mabooo18/SteiStat/journal/paper4/main.tex

%% Steistat: an open-source, object-oriented AD5941/RP2040 potentiostat,
%% a signal-chain and calibration correction campaign against Analog Devices'
%% AD5940 evaluation-kit reference firmware, and hardware-validated
%% performance characterization (resistor and Randles dummy-cell CV, CA,
%% SWV, DPV).
%% HardwareX article format (Elsevier elsarticle class).
%% Compile: pdflatex main; bibtex main; pdflatex main x2

\documentclass[preprint,12pt]{elsarticle}

\usepackage{amsmath,amssymb}
\usepackage{graphicx}
\usepackage{float}
\usepackage{booktabs}
\usepackage{array}
\usepackage{multirow}
\usepackage{threeparttable}
\usepackage{url}
\usepackage{siunitx}
\sisetup{detect-weight=true,detect-family=true}
\usepackage[table]{xcolor}
\usepackage{tikz}
\usetikzlibrary{positioning,arrows.meta}

\newcommand{\Rcal}{R_{\mathrm{CAL}}}
\newcommand{\Rtia}{R_{\mathrm{TIA}}}
\newcommand{\Rs}{R_{s}}
\newcommand{\Rct}{R_{\mathrm{ct}}}

\graphicspath{{./figures/}}

\journal{HardwareX}

\begin{document}

\begin{frontmatter}

\title{Steistat: Object-Oriented Firmware and Hardware-Validated Accuracy
for an AD5940-Based Potentiostat}

\author[itb]{Kent Frumentius}
\author[itb]{Krishudson Clement}
\author[itb]{Isa Anshori\corref{cor}}
\ead{isaa@staff.stei.itb.ac.id}
\cortext[cor]{Corresponding author.}

\affiliation[itb]{organization={Biomedical Engineering Study Program, School of
    Electrical Engineering and Informatics, Institut Teknologi Bandung},
  city={Bandung}, country={Indonesia}}

\input{sections/0-abstract}

%%Research highlights
\begin{highlights}
\item Steistat is an open-source, AD5941/RP2040 potentiostat built directly
  from Analog Devices' own evaluation-kit reference firmware.
\item The complete hardware design files, bill of materials, and
  firmware source are openly available, enabling independent
  reproduction and further development of the Steistat platform.
\item Across all four electrochemical methods -- cyclic voltammetry (CV),
  chronoamperometry (CA), square-wave voltammetry (SWV), and differential
  pulse voltammetry (DPV) -- the corrected signal chain produces
  correctly-signed, non-degenerate output on real hardware.
\item Cyclic voltammetry against a traceable Randles dummy cell recovers
  $R=\SI{10605.1\pm0.9}{\ohm}$ against a \SI{10560}{\ohm} nominal value
  ($+0.427\,\%$ error, $R^2\geq0.9999986$), independently reproducing an
  earlier measurement on the same corrected firmware.
\item Measurement latency is bounded and datasheet-matched: each
  conversion settles within $\approx$\SI{13.3}{\milli\second}
  ($\approx$\SI{75}{\hertz} ceiling), with every previously unbounded wait
  loop now timeout-protected; against a plain \SI{10}{\kilo\ohm} resistor,
  the same corrected chain recovers $R=\SI{10005.9}{\ohm}$
  ($+0.06\,\%$ error, $R^2=0.9999988$).
\end{highlights}

\end{frontmatter}

\input{sections/1-specifications}
\input{sections/2-hardware-in-context}
\input{sections/3-hardware-description}
\input{sections/4-design-files-summary}
\input{sections/5-bill-of-materials}
\input{sections/6-build-instructions}
\input{sections/7-operation-instructions}
\input{sections/8-validation}
\input{sections/9-discussion}
\input{sections/10-conclusion}

\section*{Data and code availability}
The pre-fix and post-fix firmware source for \texttt{C\_CA}/\allowbreak
\texttt{C\_SWV}/\allowbreak\texttt{C\_DPV}/\allowbreak
\texttt{C\_DCPotentiostatMethod}, the code-verification notes
against the Analog Devices reference examples, this paper's own raw
dummy-cell serial logs (chronoamperometry, cyclic voltammetry against both
the \SI{10}{\kilo\ohm} resistor and the Randles cell, square-wave and
differential-pulse voltammetry), and all hardware design files (schematic,
PCB, Gerbers, BOM, pick-and-place) are available in the project repository,
\url{https://github.com/mabooo18/SteiStat}.

\section*{CRediT authorship contribution statement}
\textbf{Kent Frumentius}: Conceptualization (hardware), Methodology
(hardware), Software, Investigation, Writing -- original draft.
\textbf{Krishudson Clement}: Conceptualization (hardware), Methodology
(hardware), Writing -- review \& editing.
\textbf{Isa Anshori}: Conceptualization, Supervision, Project
administration, Funding acquisition.

\section*{Declaration of competing interest}
The authors declare no competing financial interests or personal relationships
that could have appeared to influence the work reported in this paper.

\section*{Acknowledgements}
%% [DATA REQUIRED]: funding sources/acknowledgements, if any.

\bibliographystyle{elsarticle-num}
\bibliography{references}

\end{document}
