mabooo18/SteiStat/journal/paper4/sections/4-design-files-summary.tex

\section{Design files summary}
\label{sec:design-files}

Table~\ref{tab:designfiles} lists the design files this paper's hardware
and firmware are built from, all available in the project repository
(\url{https://github.com/mabooo18/SteiStat}).

\begin{table}[H]
\centering
\footnotesize
\setlength{\tabcolsep}{4pt}
\caption{Design files summary.}
\label{tab:designfiles}
\begin{tabular}{@{}p{3.4cm}p{2.2cm}p{7.8cm}@{}}
\toprule
Design file name & File type & Location and description \\
\midrule
\texttt{Hardware/\allowbreak STEI\_Bstat\_v1.2.kicad\_sch} & KiCad schematic &
  Full schematic: AD5941 AFE, XIAO RP2040 carrier, RCAL/RCAL2/RCAL3
  calibration bank, WE/RE/CE header \\
\texttt{Hardware/\allowbreak STEI\_Bstat\_v1.2.kicad\_pcb} & KiCad PCB layout &
  \SI{45.0}{} $\times$ \SI{60.0}{\milli\metre}, 2-layer board \\
\texttt{Hardware/\allowbreak Gerber\_PCB.zip} & Gerber (RS-274X) &
  Fabrication files for any PCB manufacturer \\
\texttt{Hardware/\allowbreak Production/\allowbreak bom-1.csv} & CSV bill of materials & Machine-generated
  from the current \texttt{.kicad\_pcb}; source for Table~\ref{tab:bom} \\
\texttt{Hardware/\allowbreak Production/\allowbreak positions.csv} & CSV pick-and-place & Component
  placement (designator, footprint, X/Y, rotation, side) for SMT assembly \\
\texttt{Hardware/\allowbreak Schematic\_AD5941 corr. circ. diag.\_2025-12-14.pdf} & PDF & Rendered
  schematic for quick reference without KiCad installed \\
\texttt{Software/\allowbreak AD5941\_25/} & Arduino sketch (C++) & Complete firmware source:
  \texttt{AD5941\_25.ino}, \texttt{cv.cpp}/\texttt{rampTest.cpp} (legacy CV
  engine), \texttt{src/electrochemical\_methods/} (\texttt{C\_CA},
  \texttt{C\_SWV}, \texttt{C\_DPV}, \texttt{C\_DCPotentiostatMethod},
  \texttt{C\_ElectrochemicalMethod}, \texttt{C\_EIS}, \texttt{C\_OCP},
  \texttt{C\_CV}), \texttt{src/communication/} (\texttt{C\_Communication}),
  \texttt{src/data\_storage/} (\texttt{C\_DataStorage}) \\
\texttt{python\_ui/} & Python (pyserial) & Host-side test/GUI scripts used
  to drive the ASCII command protocol (Section~\ref{sec:operation}) for
  this paper's own validation data collection (Section~\ref{sec:validation}) \\
\bottomrule
\end{tabular}
\end{table}
