mabooo18/SteiStat/journal/paper4/sections/1-specifications.tex

\section*{Specifications table}
\label{sec:specifications}

\begin{table}[H]
\centering
\footnotesize
\renewcommand{\arraystretch}{1.3}
\begin{tabular}{@{}p{3.2cm}p{10.5cm}@{}}
\toprule
\textbf{Hardware name} & Steistat \\
\textbf{Subject area} & Engineering and materials science; Biomedical engineering; Electrochemistry \\
\textbf{Hardware type} & Electrical engineering and computer science -- measuring instrument (potentiostat) \\
\textbf{Closest commercial analog} & Benchtop potentiostat/impedance analyzer (e.g., PalmSens4) \\
\textbf{Open source license} & CERN-OHL-S v2 \\
\textbf{Cost of hardware} & USD \SI{31.07}{} per unit, components only, at single-unit LCSC pricing (Table~\ref{tab:bom}); excludes PCB fabrication and SMT assembly labor. %% [DATA REQUIRED]: add fabrication/assembly cost once quoted.
 \\
\textbf{Source file repository} & \url{https://github.com/mabooo18/SteiStat} \\
\bottomrule
\end{tabular}
\end{table}
