mabooo18/SteiStat/Hardware/DFM analysis report_JLCDFM_STEI_Bstat_v1.2.pdf

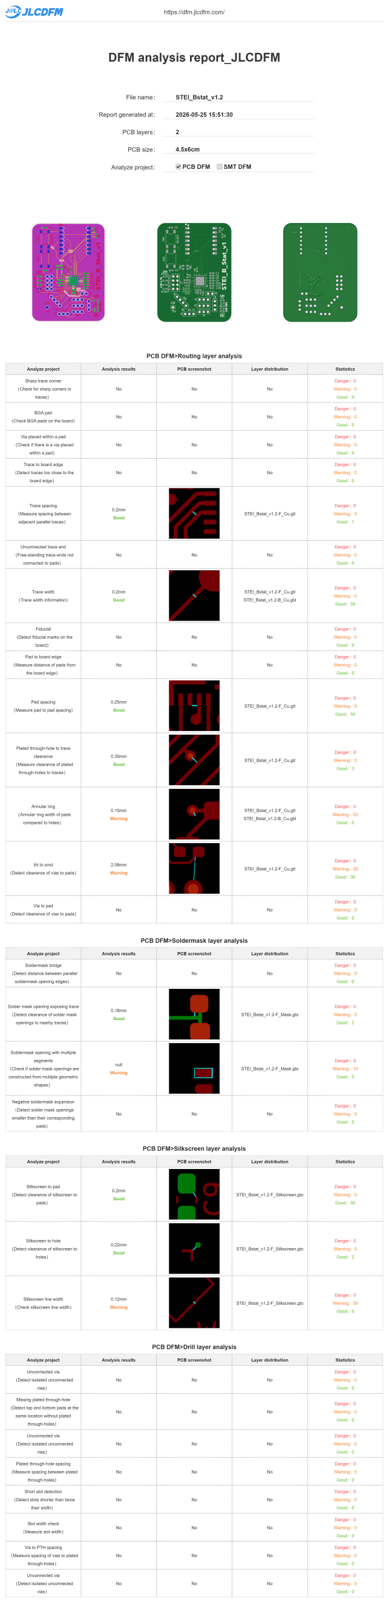
[picture p9: page 1]
