mabooo18/SteiStat/Software/update 8 (22 September 26)/AD5941_25/ppt gambar.pdf

# Update Potensiostat

Dipresentasikan oleh

KENT

### 30 MEI 26

Daftar Isi:
1.Dokumen (diagram blok, RCAL)
2. Foldering Software
3. Laporan jasa Potensiostat

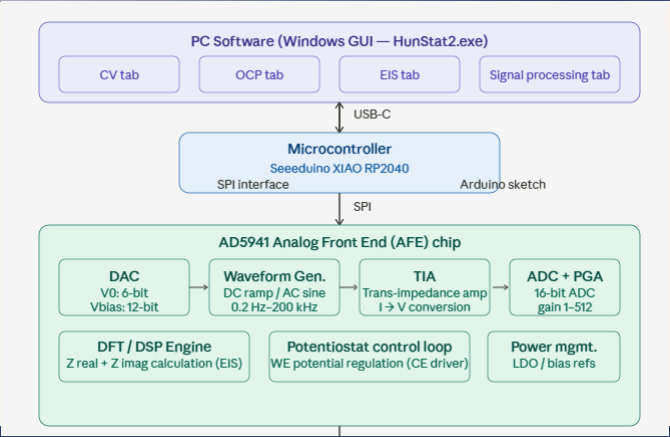
[picture p10: figure]

### 1. Dokumen (Diagram Blok)

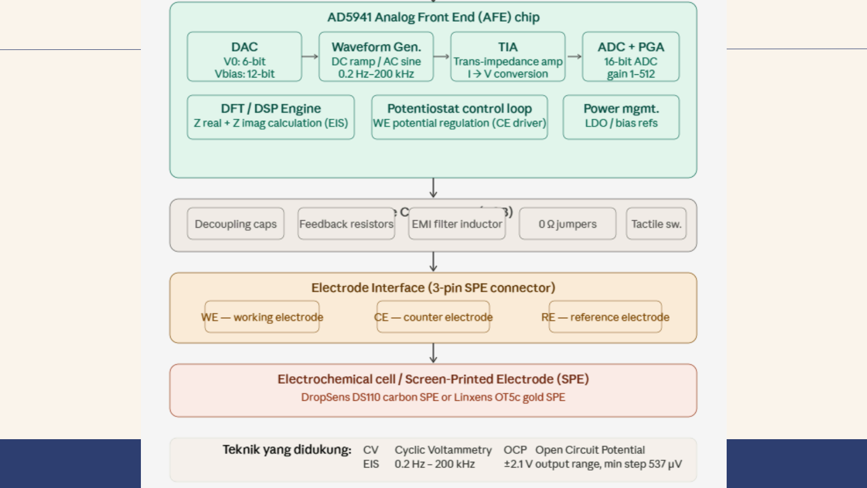
[picture p11: page 4]
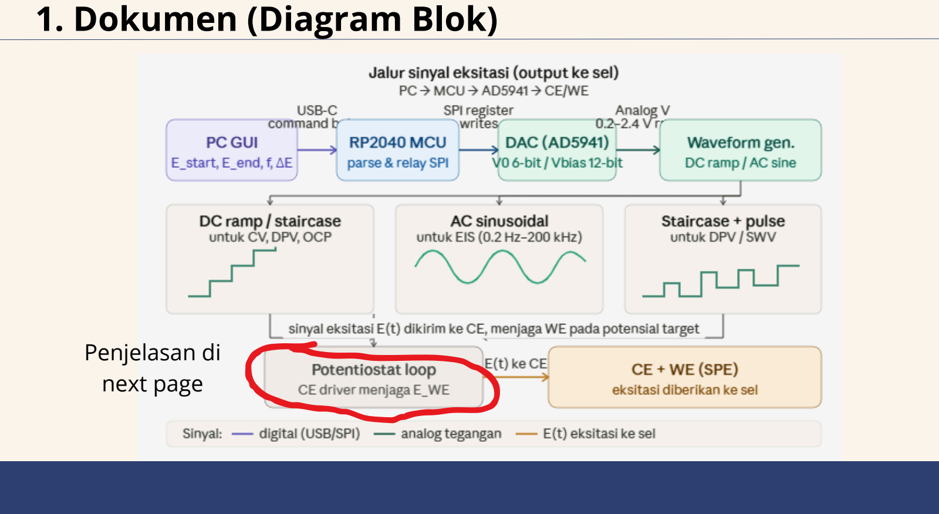
[picture p12: page 5]

### 1. Dokumen (Diagram Blok)

Penjelasan di
next page

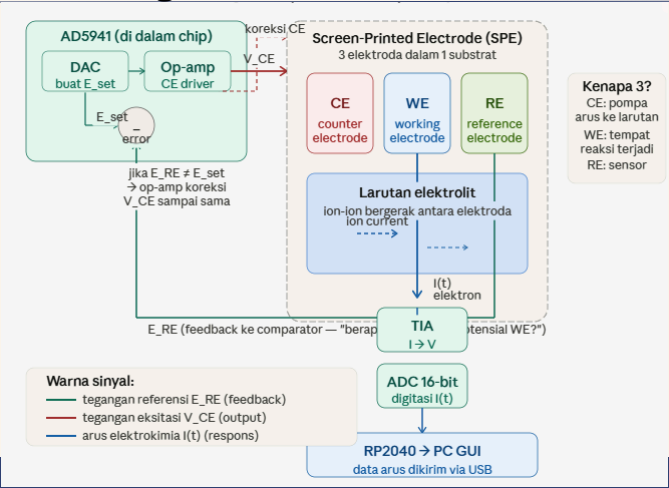
[picture p13: figure]

### 1. Dokumen (Diagram Blok)

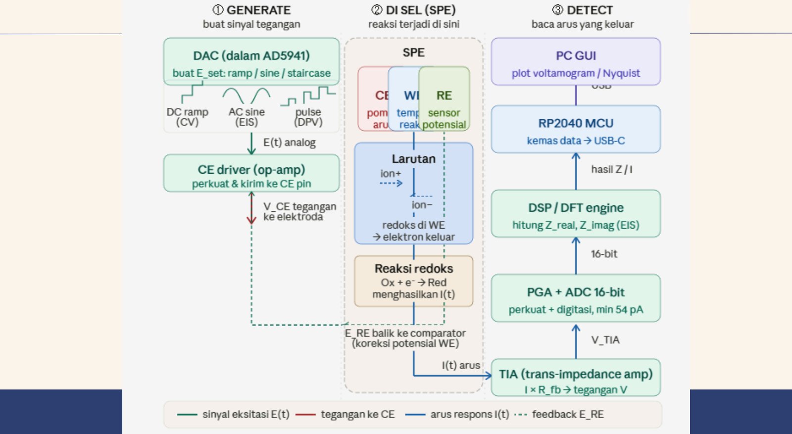
[picture p14: page 7]

### 1. Dokumen (Diagram Blok)

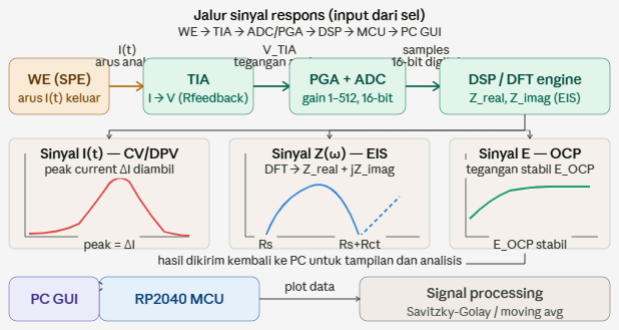
[picture p15: figure]

### 1. Dokumen (RCAL)

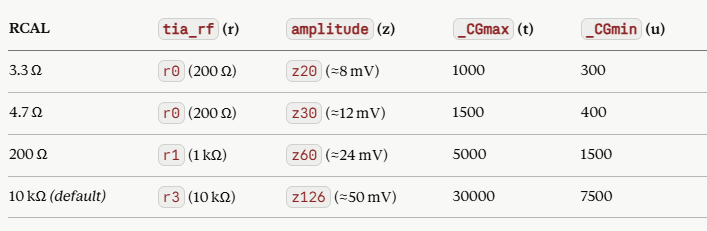
[picture p16: figure]

### 1. Dokumen (RCAL)

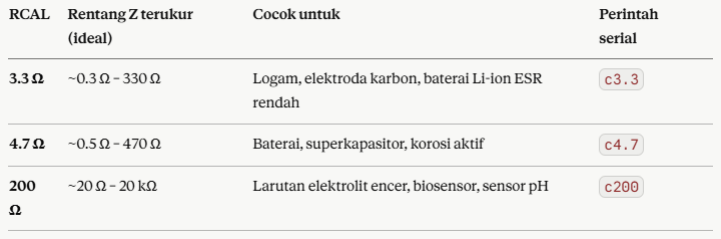
[picture p17: figure]
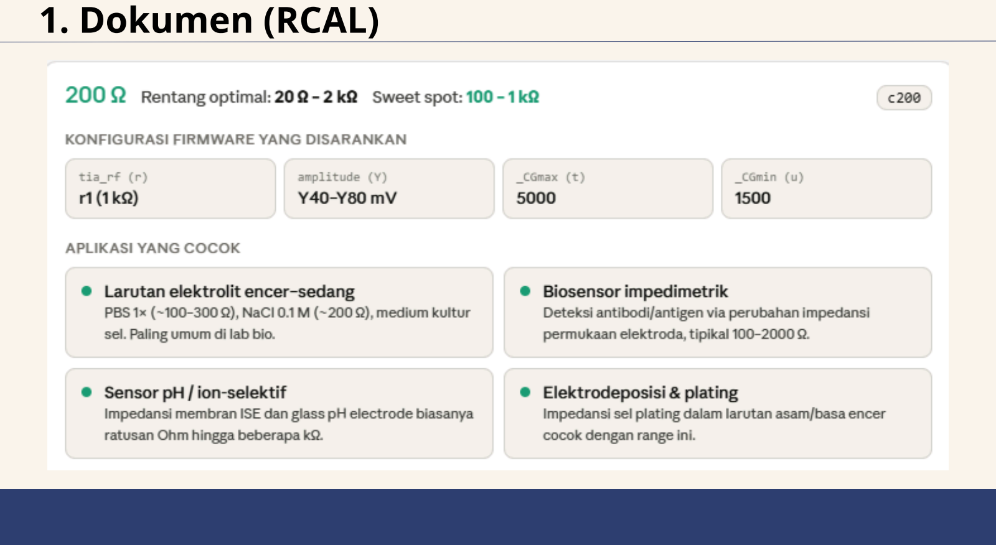
[picture p18: page 11]

### 1. Dokumen (RCAL)

### 1. Dokumen (RCAL)

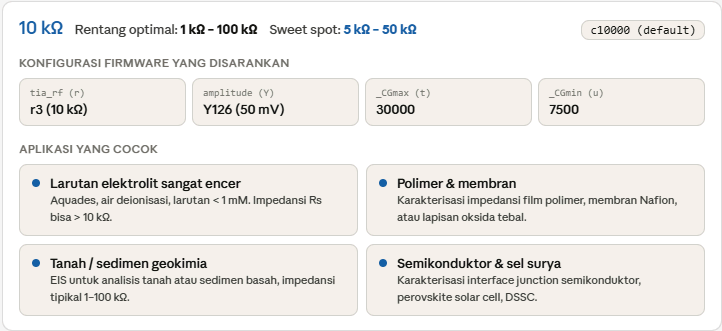
[picture p19: figure]

2.Foldering Software

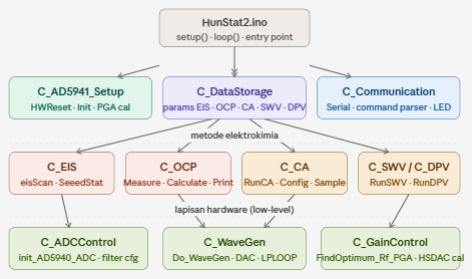
[picture p20: figure]

2.Foldering Software

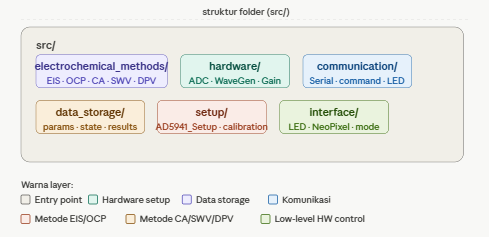
[picture p21: figure]
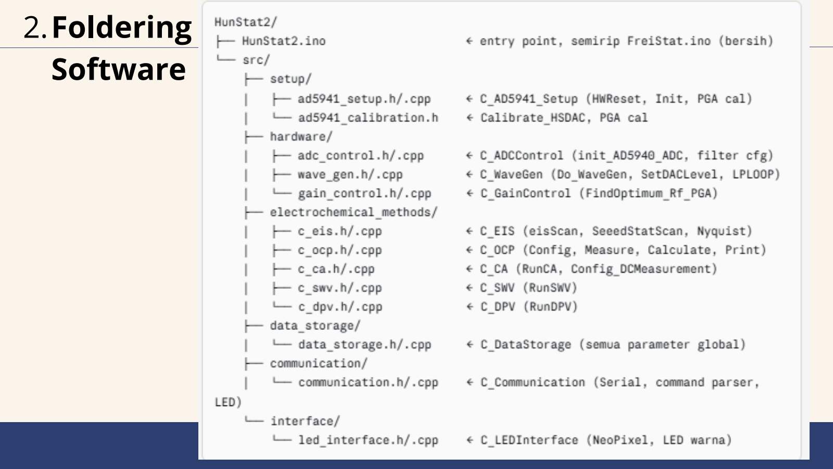
[picture p22: page 15]

2.Foldering
Software

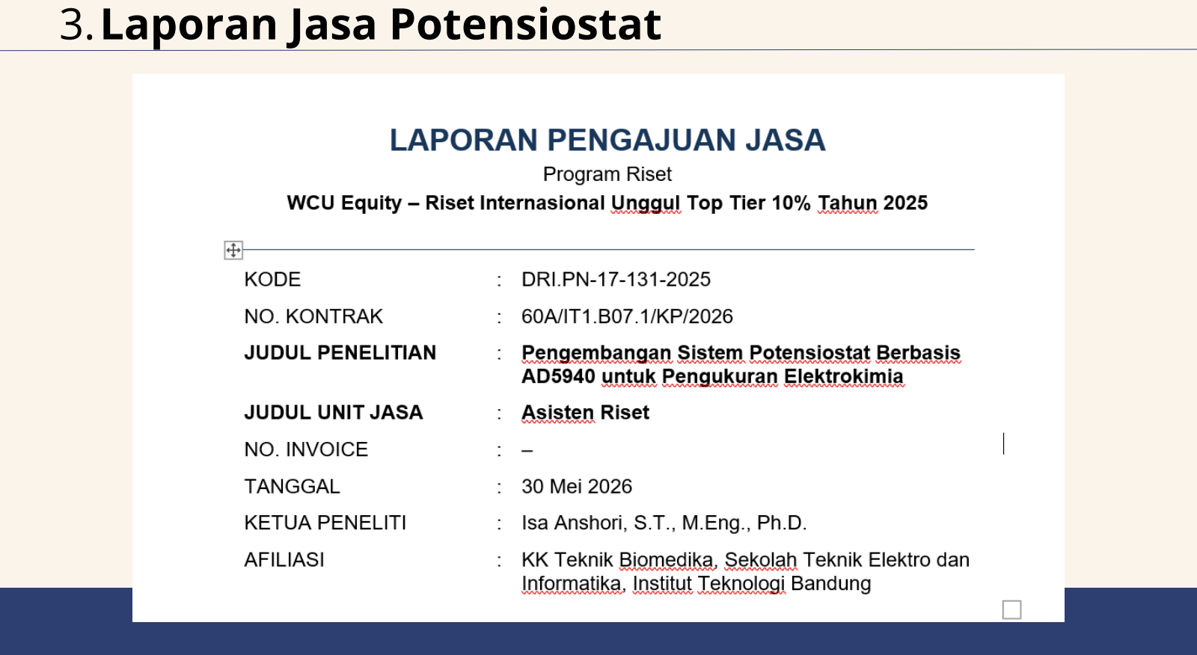
[picture p23: page 16]

3.Laporan Jasa Potensiostat
