mabooo18/SteiStat/journal/paper/figures/fig4_repeatability.pdf

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

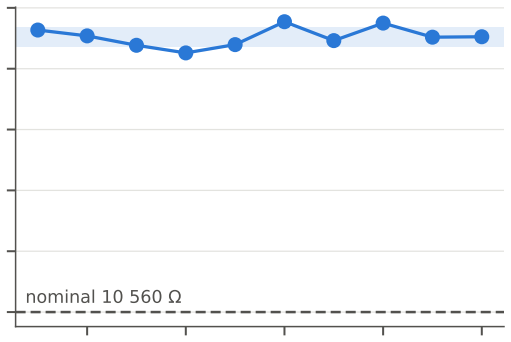
[picture p24: figure]
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
