mabooo18/SteiStat/journal/paper4/figures/fig_cv_linear_fit.png

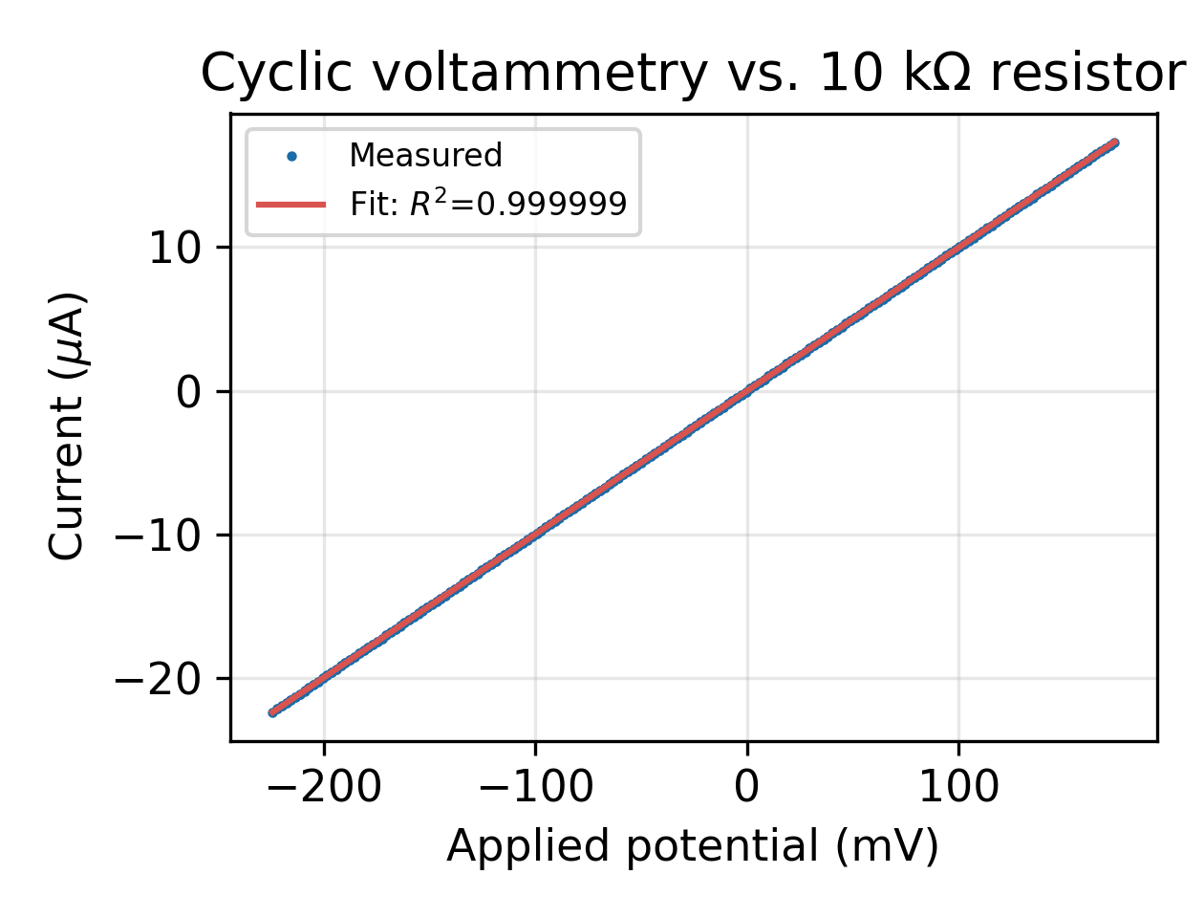
journal/paper4/figures/fig_cv_linear_fit.png
