mabooo18/SteiStat/journal/paper4/figures/fig_dpv.png

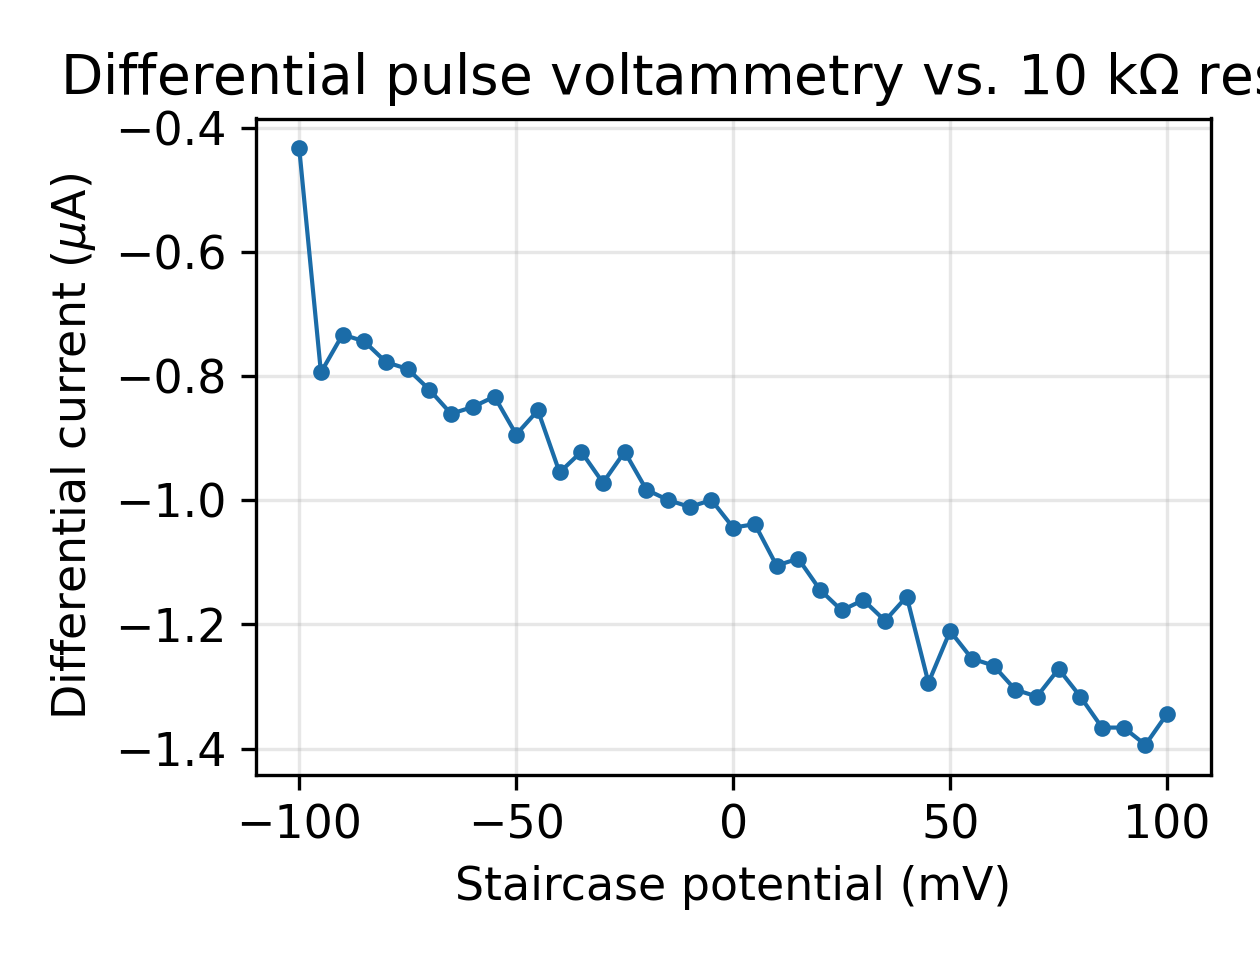
journal/paper4/figures/fig_dpv.png
