mabooo18/SteiStat/journal/paper4/figures/fig_swv.png

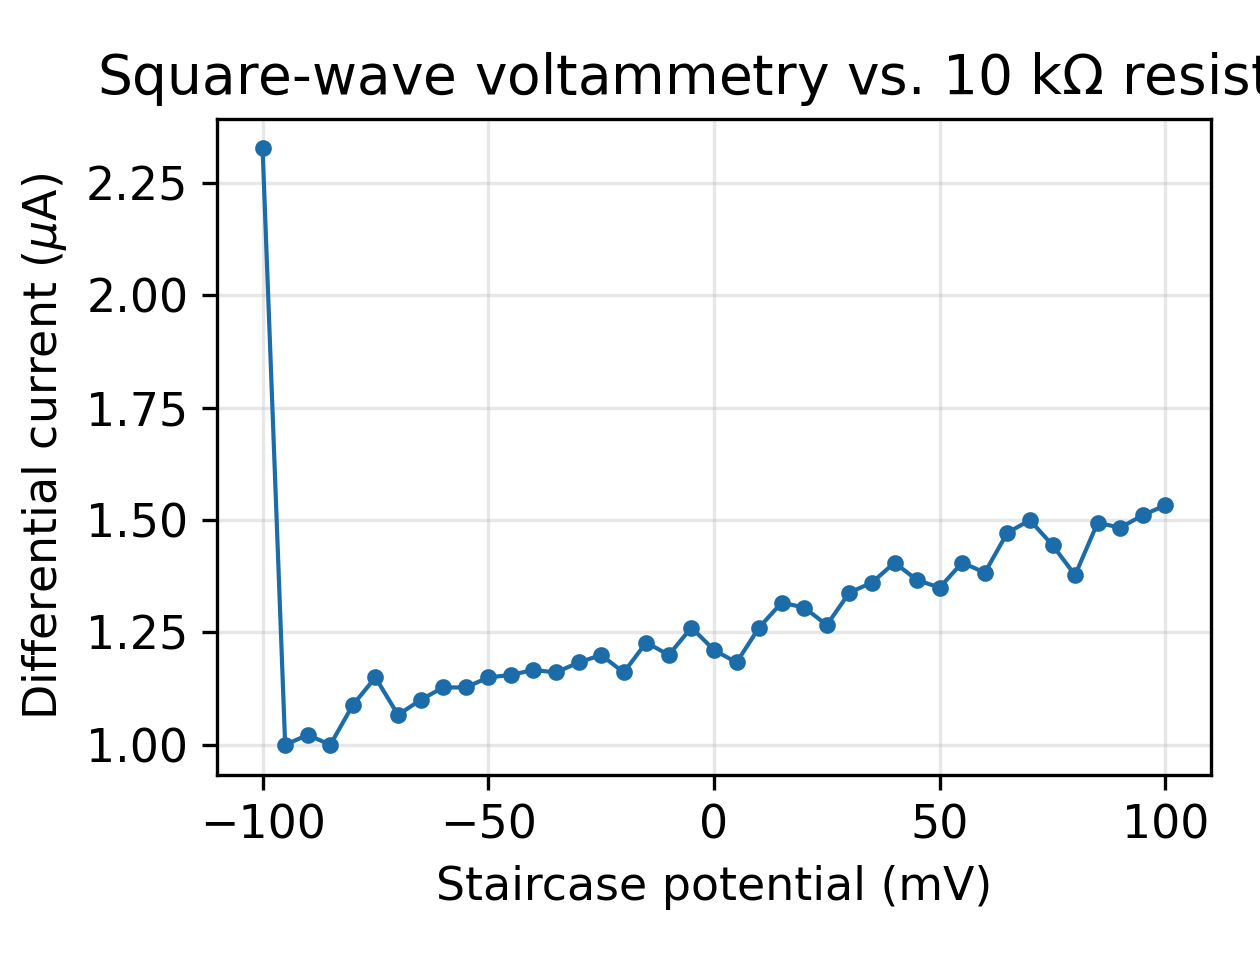
journal/paper4/figures/fig_swv.png
