mabooo18/SteiStat/Software/update 8 (22 September 26)/AD5941_25/hasil/dummy cell.png

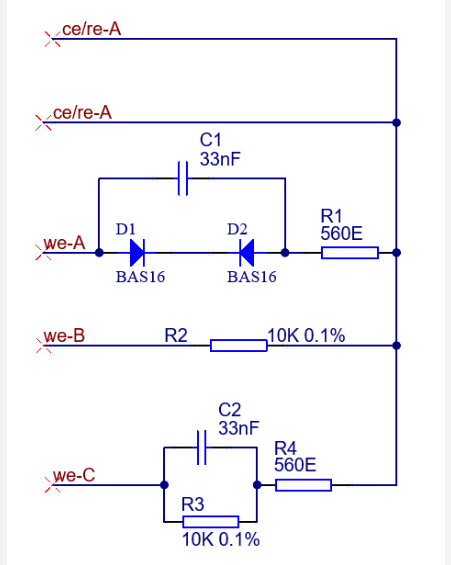
Software/update 8 (22 September 26)/AD5941_25/hasil/dummy cell.png
