mabooo18/SteiStat/Software/update 8 (22 September 26)/AD5941_25/hasil/SWV.png

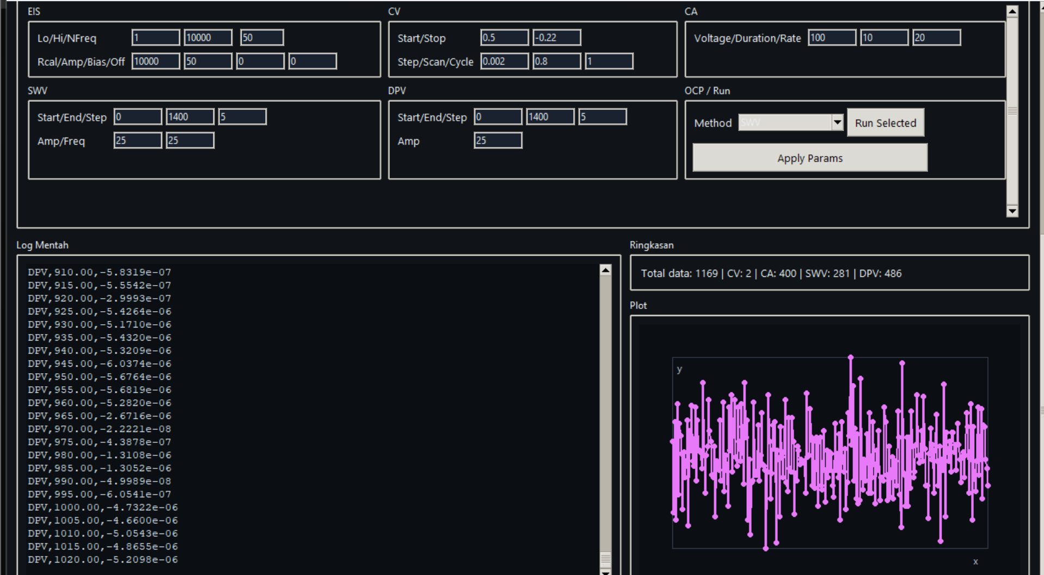
Software/update 8 (22 September 26)/AD5941_25/hasil/SWV.png
