mabooo18/SteiStat/Software/update 8 (22 September 26)/AD5941_25/hasil_fixed/dpv_test1.csv

voltage_mV | delta_current_A
-100.00 | -6.0541e-07
-90.00 | -2.2883e-06
-80.00 | -2.2661e-06
-70.00 | -2.1828e-06
-60.00 | -2.0995e-06
-50.00 | -2.0273e-06
-40.00 | -1.9662e-06
-30.00 | -1.9495e-06
-20.00 | -1.9329e-06
-10.00 | -1.8440e-06
0.00 | -1.8107e-06
10.00 | -1.7274e-06
20.00 | -1.6385e-06
30.00 | -1.6329e-06
40.00 | -1.5441e-06
50.00 | -1.4941e-06
60.00 | -1.4219e-06
70.00 | -1.4385e-06
80.00 | -1.3830e-06
90.00 | -1.3330e-06
100.00 | -1.2552e-06
