mabooo18/SteiStat/Software/update 8 (22 September 26)/AD5941_25/oop_validation/10k_resistor_refactored_only/cv_10k.csv

voltage_mV | current_A
-204.69 | -20.49
-199.85 | -19.98
-195.02 | -19.5
-190.18 | -19.02
-185.35 | -18.55
-180.51 | -18.07
-175.68 | -17.59
-170.84 | -17.08
-166.01 | -16.63
-161.17 | -16.12
-156.34 | -15.64
-151.5 | -15.16
-146.67 | -14.69
-141.83 | -14.21
-137.0 | -13.7
-132.16 | -13.25
-127.33 | -12.74
-122.49 | -12.26
-117.66 | -11.78
-112.82 | -11.31
-107.99 | -10.83
-103.15 | -10.31
-98.32 | -9.84
-93.48 | -9.36
-88.64 | -8.88
-83.81 | -8.4
-78.97 | -7.92
-74.14 | -7.41
-69.3 | -6.93
-64.47 | -6.46
-59.63 | -5.98
-54.8 | -5.5
-49.96 | -5.02
-45.13 | -4.54
-40.29 | -4.06
-35.46 | -3.55
-30.62 | -3.07
-25.79 | -2.6
-20.95 | -2.08
-16.12 | -1.64
-11.28 | -1.13
-6.45 | -0.65
-1.61 | -0.17
3.22 | 0.31
8.06 | 0.79
12.89 | 1.3
17.73 | 1.74
22.56 | 2.25
27.4 | 2.73
32.23 | 3.21
37.07 | 3.72
41.9 | 4.17
46.74 | 4.68
51.58 | 5.16
56.41 | 5.64
61.25 | 6.11
66.08 | 6.59
70.92 | 7.07
75.75 | 7.58
80.59 | 8.06
85.42 | 8.54
90.26 | 9.02
95.09 | 9.5
99.93 | 9.97
104.76 | 10.45
109.6 | 10.93
114.43 | 11.41
119.27 | 11.89
124.1 | 12.4
128.94 | 12.88
133.77 | 13.35
138.61 | 13.83
143.44 | 14.31
148.28 | 14.79
153.11 | 15.27
157.95 | 15.75
162.78 | 16.26
167.62 | 16.7
172.45 | 17.21
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
