mabooo18/SteiStat/Software/update 8 (22 September 26)/AD5941_25/oop_validation/10k_resistor_refactored_only/dpv_10k.csv

x | y
0.0 | -1.0775e-06
20.0 | -1.1386e-06
40.0 | -1.1331e-06
60.0 | -1.2386e-06
80.0 | -1.2664e-06
100.0 | -1.4552e-06
120.0 | -1.4274e-06
140.0 | -1.5441e-06
160.0 | -1.6718e-06
180.0 | -1.7773e-06
200.0 | -1.7773e-06
