mabooo18/SteiStat/journal/02_oop_analysis.md

# OOP Analysis — SteiStat / AD5941_25 Firmware

**Method:** every `.h`/`.cpp` file under `AD5941_25/src/` was read in full. A repo-wide search for `virtual`, `: public` (inheritance), `override`, and `template<` returned **zero matches** in project code (only present, if at all, inside the vendor AD5940 driver — which itself has none either). This single fact governs the whole assessment below: whatever encapsulation exists, there is no inheritance, no polymorphism, and no interface abstraction anywhere in the codebase.

## Per-File Table

| File | Class/Module | Responsibility | OOP Concept Present | Dependencies | Problems | Recommended Improvement |
|---|---|---|---|---|---|---|
| `electrochemical_methods/c_ca.h/.cpp` | `C_CA` | Run one chronoamperometry sweep | Class with private helper methods (`ConfigDCMeasurement`, `MeasureCurrentRaw`, `RawToCurrent`); state is a raw pointer to a shared `C_DataStorage` | Direct calls to ~9 `AD5940_*` register functions, 5 `extern` globals, Arduino `Serial`/`delay` | `ConfigDCMeasurement()` is byte-for-byte duplicated in `C_DPV`/`C_SWV`; class fuses hardware config + unit conversion + timing + LED + Serial I/O; no error handling on ADC timeout | Extract a shared `PotentiostatHAL` for register config; separate a `UnitConverter`; return status/error codes |
| `electrochemical_methods/c_dpv.h/.cpp` | `C_DPV` | Run one DPV sweep | Same shape as `C_CA` | Same as `C_CA` | Verbatim duplicate of `C_CA`'s config/measure/convert code | Same as above; factor common base |
| `electrochemical_methods/c_swv.h/.cpp` | `C_SWV` | Run one SWV sweep | Same shape as `C_CA` | Same as `C_CA` | Verbatim duplicate of `C_CA`'s config/measure/convert code | Same as above |
| `electrochemical_methods/c_eis.h/.cpp` | `C_EIS` | Run EIS frequency sweep + Nyquist conversion | Class, but 2 declared private methods (`CalculateMagAndPhase`, `CalculateNyquistPoint`) are never defined — dead declarations; other helpers live as free `static` functions in the same file, not as methods | ~20 `extern` globals, ~15 `AD5940_*` calls, calls into `measurement_buffer` module | `Run()` is a single ~110-line function mixing clock config, power-mode switching, GPIO, FIFO reads, Serial I/O | Split into `EisFrequencySweeper` + `NyquistCalculator`; move statics into the class or a HAL |
| `electrochemical_methods/c_ocp.h/.cpp` | `C_OCP` | Configure/measure/compute open-circuit potential | Class with one private helper; one more free `static` helper sits outside the class in the same file | ~25 `extern` globals, ~9 `AD5940_*`/Arduino calls | `Calculate()` embeds a magic-number physical formula independently of the near-identical pattern in `RawToCurrent()` (C_CA/DPV/SWV) — same architectural role implemented twice with no shared abstraction | Introduce one shared `AdcCodeConverter` used by all method classes |
| `electrochemical_methods/electrochemical_methods.h/.cpp` | **none — free functions** | Documented ("backward-compatibility") procedural re-implementation of CA/SWV/DPV | None — procedural | Own separate set of global floats duplicating `C_DataStorage` fields | This is a full second implementation of CA/SWV/DPV, with its own copy of the TIA table and `Vref_mV=1820.0` magic number, reading a **different set of globals** than the class versions — a correctness hazard, not just duplication | Delete this file once callers are migrated to the class versions, or delete the classes if this path is the one actually used — do not keep both |
| `communication/communication.h/.cpp` | `C_Communication` | Parse/dispatch serial commands, own a command-history buffer | The **strongest encapsulation in the codebase**: private `m_History[2000]` + `m_pHistory` cursor, only mutated through class methods | Directly calls `AD5940_WriteReg`/`ReadReg`; drives all 5 method classes | Not cohesive — one class is simultaneously a parser (hand-rolled `sscanf` grammar), a 5-way command dispatcher, a hardware-register shim, a logger, and an orchestrator; a switch-case fallthrough pattern (e.g. `case 'B': ...; case 'b': ...`) and a reused `'!'` command code are fragile | Split into `CommandParser` + `CommandDispatcher` + a hardware-access boundary the dispatcher calls through, not around |
| `command_processing/command_processing.h/.cpp` | **none — free functions** | Parallel/legacy command parser | None — procedural | Independent set of ~35 `extern` globals; direct `AD5940_WriteReg`/`ReadReg`/`PGA_Calibration` calls | Near-total duplicate of `C_Communication`'s ~700-line grammar, maintained independently against different globals; `case` labels declare locals without braces (fragile C idiom) | Delete once confirmed unused, or merge into `C_Communication` if still load-bearing |
| `data_storage/data_storage.h/.cpp` | `C_DataStorage` | Central parameter store | **None in practice** — every field is `public`; only method is `Begin()` (sets defaults) | Read/written directly (`m_pData->Field = ...`) by every method class | Textbook "class used only as a namespace/struct"; header comment states its purpose is literally to replace `extern` globals with one shared mutable object — not encapsulation, relocation | Add private fields + accessor methods with validation (e.g. reject out-of-range voltages) if genuine encapsulation is to be claimed |
| `data_storage/measurement_buffer.h/.cpp` | **none — free functions** | Circular/linear measurement buffer | None — procedural, 3 file-scope non-`static` globals | Used by `c_eis.cpp` | A **third, divergent** copy of the buffering concept, alongside `C_DataStorage`'s own `Measurements[]`/`pMeasurement`/`NumberOfMeasurements` fields (note the casing mismatch with this file's `numberOfMeasurements`) | Pick one buffer owner; delete the other |
| `hardware/gain_control.h/.cpp` | **none — free function** `Hardware_FindOptimum_Rf_PGA` | Compute optimal TIA/PGA combination | None — procedural, but genuinely stateless/pure and well-isolated | No globals, no hardware calls | Best-isolated module in the codebase, but not OOP | Could remain a free function; if wrapped in a class it should be a stateless `GainOptimizer` value type, not more than that |
| `hardware/adc_control.h/.cpp` | **none — free function** `Hardware_Init_AD5940_ADC` (aliased `init_AD5940_ADC`) | Configure ADC filter/DFT per frequency band | None — procedural | 4 `extern` globals, 6 `AD5940_*` calls | 6-band if/else chain with unnamed magic-number band edges (`.11`, `.51`, `5`, `450`, `80000`) | Replace band edges with named constants; wrap in a `FilterBankSelector` |
| `hardware/wave_gen.h/.cpp` | **none — free function** `Hardware_Do_WaveGen` (aliased `Do_WaveGen`) | Configure clocks/reference/TIA/switch matrix/waveform generator | None — procedural | 14 `extern` globals, ~8 `AD5940_*` calls | ~90-line function mixing 5+ configuration concerns | Decompose into per-concern setup methods on a HAL class |
| `interface/led_interface.h/.cpp` | **none — free functions** | NeoPixel status LED control | None — procedural | 1 `extern` NeoPixel object it does not own | **Live bug:** `Interface_SetLed(color)` ignores its `color` argument and always renders white — every caller's intended color coding is silently defeated | Fix the bug; wrap the NeoPixel object inside a real `StatusLed` class that owns it |
| `utils/status_utils.h/.cpp` | **none — free functions** | Wraps `interface/led_interface` | None — procedural, pure pass-through | Calls `interface/` functions | Redundant indirection layer — two modules wrapping each other for no added behavior | Delete one of the two layers |
| `setup/ad5941_setup.h/.cpp` | `C_AD5941_Setup` | Chip init + PGA calibration + NeoPixel ownership | Class with one private member (`m_Pixels`) — genuine ownership of a hardware object | Calls `AD5940_HWReset/MCUResourceInit/Initialize/ADCPGACal` | `GetPixels()` returns a raw pointer to the private member, defeating the encapsulation just established; its own wrapped functions (`InitAll`, `PGACalibration`) are bypassed elsewhere in the codebase via direct calls to the underlying free functions, making the class API optional/decorative | Return a reference-with-limited-API instead of a raw pointer; make the underlying free functions private/internal so the class is the only entry point |
| `setup/ad5941_calibration.h` | — | (empty file, 0 bytes) | N/A | N/A | Dead placeholder | Remove or populate |
| `ad5940/ad5940.h/.cpp`, `ad5940/debug.h` | — | Vendor AD5941 register driver | None (confirmed by grep) | N/A — this is the substrate everything else calls into | Not project code; correctly cited as a third-party dependency, not a contribution | N/A |

## Duplication Summary (separate from the per-file table because it crosses files)

The codebase ships **two parallel implementations** of the same functionality in two places:

1. **CA/SWV/DPV**: class-based (`C_CA`, `C_SWV`, `C_DPV`, bound to `C_DataStorage`) *and* free-function (`electrochemical_methods.cpp`, bound to its own separate globals), with identical register-configuration code and magic numbers copy-pasted three times within the class versions alone.
2. **Command processing**: class-based (`C_Communication`, ~622 lines) *and* free-function (`command_processing.cpp`, ~704 lines), each independently implementing the same ASCII command grammar against disjoint sets of global variables.

Both duplications matter for the paper: they are direct evidence against an "OOP refactor" narrative, and they are a correctness risk (two code paths can diverge on the same nominal parameter).

## Overall Verdict: **Partially OOP** (weak end of "partial")

Justification, in order of weight:

1. **No inheritance, polymorphism, or interfaces anywhere in project code.** Five electrochemical-method classes (`C_CA`, `C_DPV`, `C_SWV`, `C_EIS`, `C_OCP`) are a textbook case for a common `IElectrochemicalMethod` base with a virtual `Run()` — none exists. `C_CA::ConfigDCMeasurement()`, `C_DPV::ConfigDCMeasurement()`, and `C_SWV::ConfigDCMeasurement()` are verbatim-identical instead of being one shared base method.
2. **The central "class," `C_DataStorage`, has 100% public fields and a single trivial method.** Its own source comment states its purpose is to replace `extern` globals with one shared object — a relocation of global state, not encapsulation. Every method class reaches directly into its public fields.
3. **Every method class is directly coupled to the vendor register-driver API and to Arduino runtime calls (`Serial`, `digitalWrite`, `delay`) inside the same functions that do unit conversion and protocol framing.** There is no hardware-abstraction-layer interface standing between "measurement logic" and "register access" — which is the opposite of what an "OOP potentiostat" claim would need to demonstrate.
4. **Two full parallel implementations of the command layer and of CA/SWV/DPV exist simultaneously** (class-based vs. free-function), indicating the OOP layer was added alongside, not integrated into, the original procedural firmware.
5. **Genuine encapsulation exists only in two places**: `C_Communication` (private history buffer, real invariant it manages) and `C_AD5941_Setup` (private NeoPixel object, though leaked via a raw-pointer getter). The other six classes use `class` as a grouping syntax indistinguishable from a namespace.

### What this means for the paper

The manuscript **cannot** honestly claim "strong OOP architecture," "polymorphic method dispatch," or "clean hardware abstraction layer" as currently implemented. It *can* honestly claim: a partial migration from procedural/global-variable C toward C++ classes, with identified concrete next steps (Phase 3 architecture) to complete that migration — e.g., a shared base class for electrochemical methods, a real HAL boundary, and removal of the duplicate free-function code paths. Positioning the paper's contribution around "we diagnose the current architecture and propose/implement a completed OOP refactor" is defensible from the evidence; claiming the *current* code is already a mature OOP design is not.
