mabooo18/SteiStat/journal/elsevier.tex

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

\documentclass[preprint,12pt]{elsarticle}

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

\usepackage{amssymb}
\usepackage{amsmath}
\usepackage{graphicx}
\usepackage{array}
\usepackage{url}
\usepackage{float}

\journal{[DATA REQUIRED: Journal Name]}

\begin{document}

\begin{frontmatter}

%% Title, authors and addresses

\title{Design and Implementation of an Object-Oriented Potentiostat\\ With Performance Evaluation Using a Dummy Cell}

%% [DATA REQUIRED]: real author names, affiliations, and contact emails were
%% not available in the repository and must be filled in before submission.
\author[1]{Author~Name}
\author[2]{Author~Name}

\affiliation[1]{organization={[DATA REQUIRED: institution / department]},
            addressline={},
            city={[DATA REQUIRED: city]},
            postcode={},
            state={},
            country={[DATA REQUIRED: country]}}

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

%% \ead{[DATA REQUIRED: corresponding author e-mail]}

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

%%Graphical abstract
\begin{graphicalabstract}
%% [OPTIONAL] \includegraphics{figures/graphical_abstract}
\end{graphicalabstract}

%%Research highlights
\begin{highlights}
\item Audited HunStat2's AD5941/RP2040 firmware and found it configured the wrong excitation/sensing loop for CA/SWV/DPV.
\item Corrected the excitation-loop and ADC zero-point defects and validated the fix on physical hardware.
\item Post-fix CV shows near-ideal linearity against Ohm's law ($R^2 = 0.999997$).
\item Reports an honest, evidence-based audit of the firmware's object-oriented design maturity.
\end{highlights}

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

\end{frontmatter}

%% main text

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

\section{System Design and Implementation}

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

\section{Performance Evaluation}

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

\subsection{Performance Evaluation Against a Dummy Cell}
\label{sec:eval_dummy}

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

\begin{figure}[t]
\centering

\caption{Chronoamperometry current transient following a $0\rightarrow+200$~mV potential step against the dummy cell (\texttt{r3}, 10~k$\Omega$ LPTIA RTIA).}
\label{fig:ca_transient}
\end{figure}

\begin{figure}[t]
\centering

\caption{Initial chronoamperometry transient current versus applied step voltage, showing a polarity- and magnitude-consistent response.}
\label{fig:ca_vs_step}
\end{figure}

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

\begin{figure}[t]
\centering

\caption{Cyclic voltammetry response across a triangular potential sweep, with linear fit ($R^2=0.999997$).}
\label{fig:cv}
\end{figure}

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

\begin{figure}[t]
\centering

\caption{Square-wave voltammetry differential current across the dummy cell.}
\label{fig:swv}
\end{figure}

\begin{figure}[t]
\centering

\caption{Differential pulse voltammetry differential current across the dummy cell.}
\label{fig:dpv}
\end{figure}

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

\subsection{Performance Evaluation Against an Electrolyte Solution}
\label{sec:eval_solution}
This subsection reports the instrument's response against a real electrolyte solution, complementing the dummy-cell results of Section~\ref{sec:eval_dummy} with genuine Faradaic/electrochemical behavior. \textbf{[DATA REQUIRED]}: solution measurements had not yet been collected/finalized at the time of this draft; the structure below mirrors Section~\ref{sec:eval_dummy} and should be completed with real data, figures, and captions before submission.

\subsubsection{Experimental Setup}
\textbf{[DATA REQUIRED]}: identity and concentration of the electrolyte/redox solution used (e.g. supporting electrolyte, redox couple), electrode materials (working/reference/counter), cell volume/geometry, and any temperature or stirring conditions, should be reported here.

\subsubsection{Chronoamperometry}
\textbf{[DATA REQUIRED]}: chronoamperometry current-transient data against the electrolyte solution, with applied potential step(s), and a figure analogous to Fig.~\ref{fig:ca_transient}.

\subsubsection{Cyclic Voltammetry}
\textbf{[DATA REQUIRED]}: cyclic voltammogram against the electrolyte solution, including peak current(s)/potential(s) if a redox-active analyte is present, and a figure analogous to Fig.~\ref{fig:cv}.

\subsubsection{Square-Wave and Differential Pulse Voltammetry}
\textbf{[DATA REQUIRED]}: SWV/DPV differential-current response against the electrolyte solution; unlike the dummy-cell result in Section~\ref{sec:eval_dummy}, a redox-active solution is expected to show a distinct voltammetric peak, and figures analogous to Figs.~\ref{fig:swv}--\ref{fig:dpv}.

\subsubsection{Open-Circuit Potential}
\textbf{[DATA REQUIRED]}: OCP measurement against the electrolyte solution, reported with the same averaging protocol used in Section~\ref{sec:eval_dummy}.

\section{Discussion}

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

\section*{Acknowledgment}
[DATA REQUIRED: acknowledgments, funding sources, if any.]

\begin{thebibliography}{9}

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

\bibitem{ref:dummycell_log}
[Internal] Sketch restructuring, dummy-cell hardware verification, and Python UI fixes session log (dummy-cell branch schematic, \S2), \texttt{laporan/UPDATE\_2026-08-01.md}, this repository, 2026.

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

\end{thebibliography}

\end{document}
