mabooo18/SteiStat/journal/contoh/main.tex

\documentclass[conference,a4paper]{IEEEtran}
\IEEEoverridecommandlockouts
% The preceding line is only needed to identify funding in the first footnote. If that is unneeded, please comment it out.
% \IEEEpubid{\makebox[\columnwidth]{979-8-3503-7705-7/24/\$31.00 \copyright2024 IEEE \hfill} \hspace{\columnsep}\makebox[\columnwidth]{ }}
\usepackage{cite}
\usepackage{amsmath,amssymb,amsfonts}
\usepackage{algorithm}
\usepackage{algorithmicx}
\usepackage{algpseudocode}
\usepackage{graphicx}
\usepackage{textcomp}
\usepackage{threeparttable}
\usepackage{xcolor}
\usepackage{array}
\usepackage[caption=false,font=normalsize,labelfont=sf,textfont=sf]{subfig}
% \usepackage[hidelinks]{hyperref}
\usepackage{url}
% \usepackage{hyperref}
\usepackage{pgfplots} 
\pgfplotsset{compat=1.16} 
% \usepackage{flushend}
\usepackage{multirow}
\usepackage[a4paper, left=1.6cm, right=1.6cm, top=1.9cm, bottom=2.64cm, columnsep=0.25in]{geometry}
% \usepackage{balance}

\graphicspath{{./images/}}

\renewcommand{\IEEEkeywordsname}{Keywords}

\title{STEI-ZStat: A Low-Cost AD5941 Potentiostat for Electrochemical Impedance Spectroscopy}

\author{
\IEEEauthorblockN{Krishudson Clement}
\IEEEauthorblockA{\textit{Institut Teknologi Bandung}\\
Bandung, Indonesia\\
teja.clement@gmail.com}
\and
\IEEEauthorblockN{Kent Frumentius}
\IEEEauthorblockA{\textit{Institut Teknologi Bandung}\\
Bandung, Indonesia\\
kent.frumentius@gmail.com}
\and
\IEEEauthorblockN{Iqbal Fawwaz Ramadhan}
\IEEEauthorblockA{\textit{National Yang Ming Chiao Tung University}\\
Hsinchu, Taiwan\\
iqbalfawwazr.st12@nycu.edu.tw}
\and[\hfill\mbox{}\par\mbox{}\hfill]
\IEEEauthorblockN{Muhammad Ogin Hasanuddin}
\IEEEauthorblockA{\textit{Inha University}\\
Incheon, South Korea\\
\textit{Institut Teknologi Bandung}\\
Bandung, Indonesia\\
moginh@inha.edu}
\and
\IEEEauthorblockN{Wervyan Shalannanda}
\IEEEauthorblockA{\textit{Institut Teknologi Bandung}\\
Bandung, Indonesia\\
\textit{Johannes Kepler University Linz}\\
Linz, Austria\\
K12239569@students.jku.at}
\and
\IEEEauthorblockN{Isa Anshori}
\IEEEauthorblockA{\textit{Biomedical Engineering Study Program}\\
\textit{School of Elect. Eng. \& Informatics}\\
\textit{Institut Teknologi Bandung}\\
Bandung, Indonesia\\
isaa@staff.stei.itb.ac.id}
}

\begin{document}
\bstctlcite{IEEEexample:BSTcontrol}
\maketitle
% \IEEEpubidadjcol

\input{0-abstract}
\input{1-introduction}
\input{2-background}
\input{3-proposed-design}
\input{4-implementation-result}
\input{5-discussion}
\input{6-conclusion}

% \balance
% Reference
\bibliography{references}
\bibliographystyle{IEEEtran}

% \IEEEpubid{\makebox[\columnwidth]{978-1-5386-5541-2/18/\$31.00~\copyright2018 IEEE \hfill} \hspace{\columnsep}\makebox[\columnwidth]{ }}

\end{document}
