mabooo18/SteiStat/journal/paper 2/figures/fig3_dummy_vs_larutan.pdf

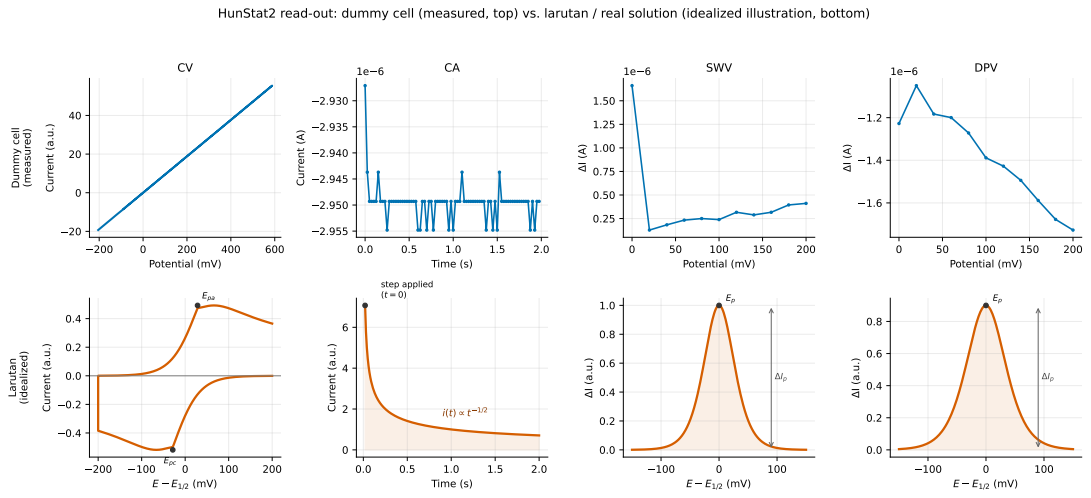
[picture p48: page 1]
Potential (mV); Dummy cell (measured); Current (a.u.); Time (s); Current (A); SWV; DPV; Larutan; (idealized); Epa; Epc; step applied (t = 0)

HunStat2 read-out: dummy cell (measured, top) vs. larutan / real solution (idealized illustration, bottom)
