mabooo18/SteiStat/journal/paper4/figures/fig1_all_methods_before_after.pdf

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

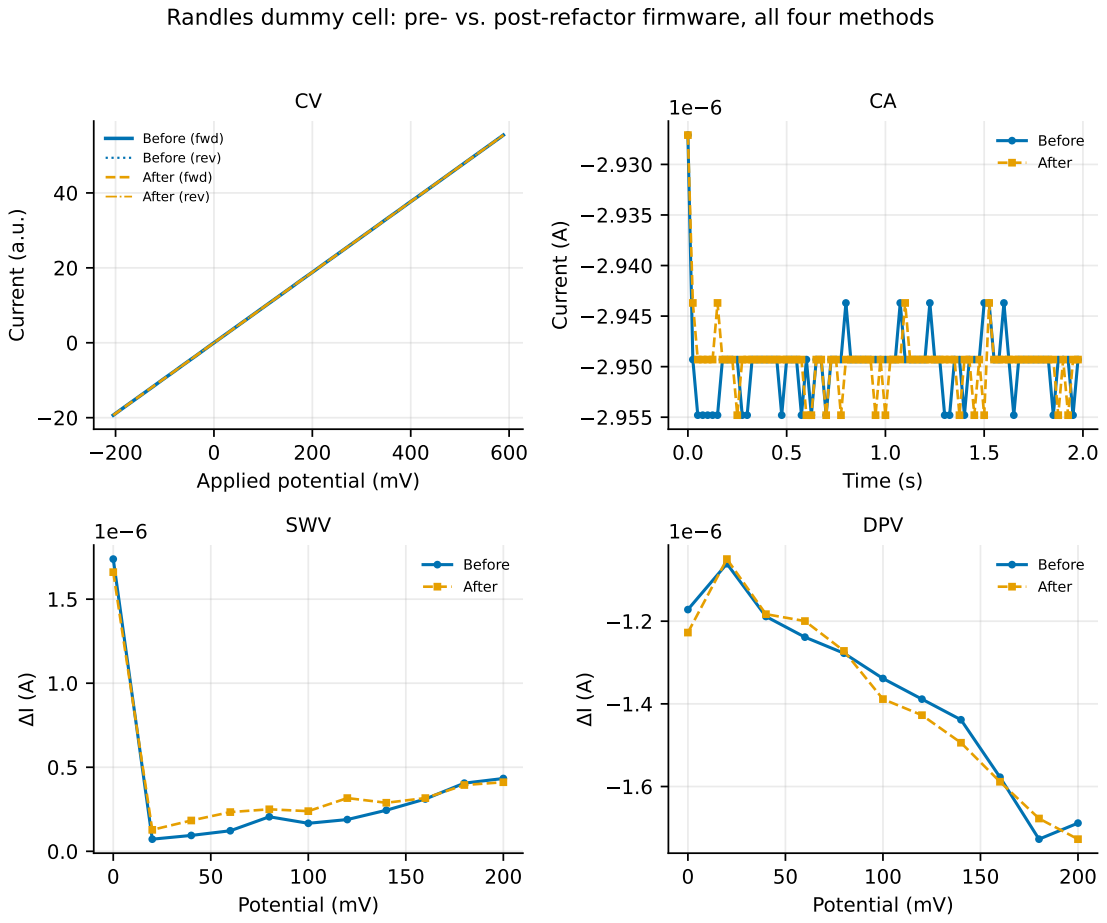
[picture p49: page 1]
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
