mabooo18/SteiStat/journal/paper4/figures/fig2_all_methods_two_loads.pdf

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

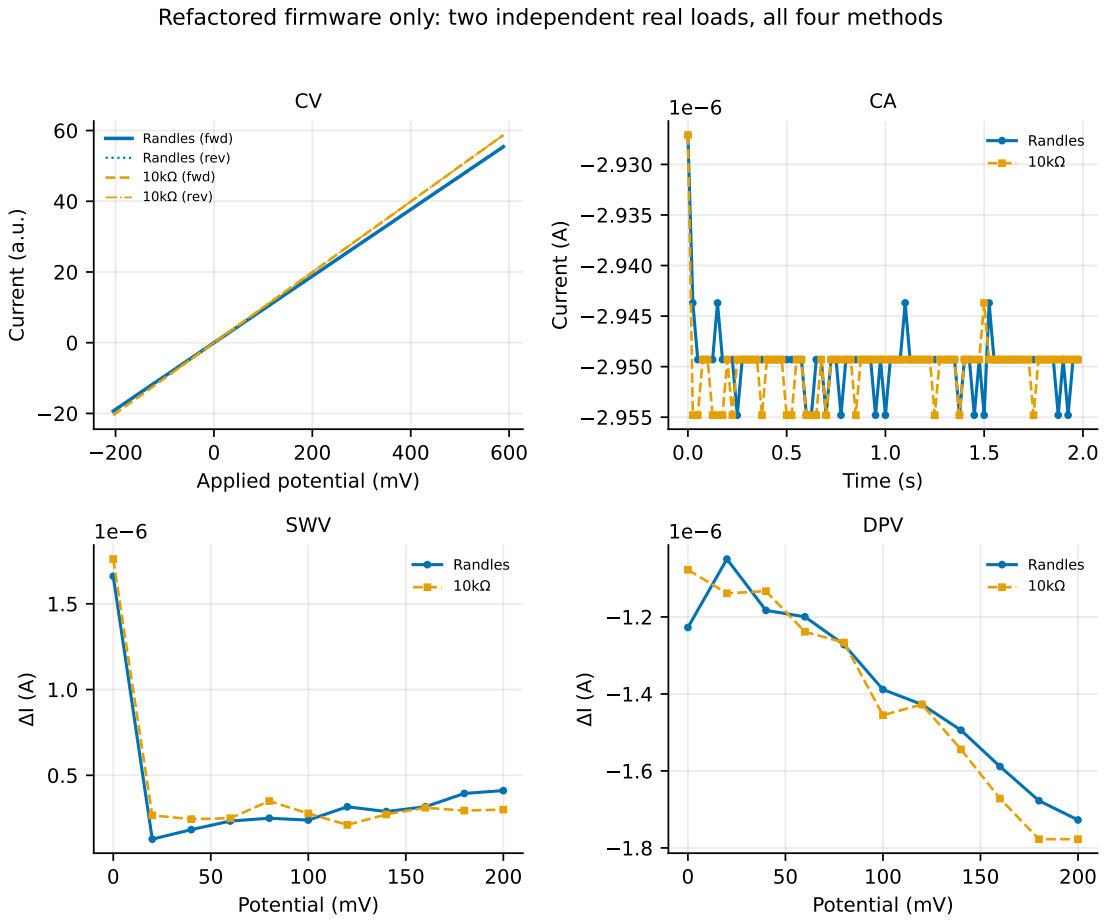
[picture p50: page 1]
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
