mabooo18/SteiStat/journal/paper/figures/fig1_setup.pdf

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

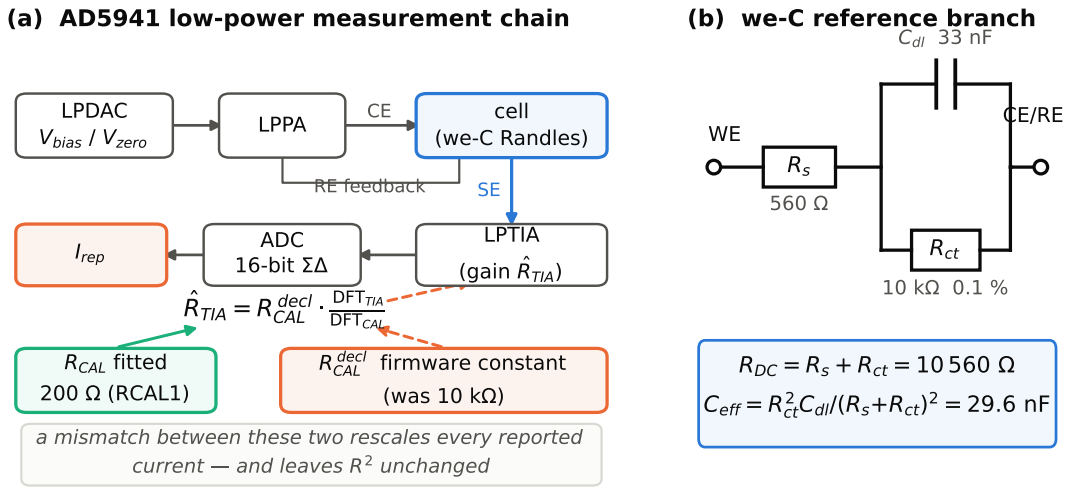
[picture p51: page 1]
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
