mabooo18/SteiStat/Software/update 8 (22 September 26)/AD5941_25/src/hardware/adc_control.h

#ifndef STEISTAT_ADC_CONTROL_H
#define STEISTAT_ADC_CONTROL_H

#include <Arduino.h>
#include "../../AD5940.h"

void Hardware_Init_AD5940_ADC(float freq);

inline void init_AD5940_ADC(float freq)
{
	Hardware_Init_AD5940_ADC(freq);
}

#endif
