mabooo18/SteiStat/Software/update 8 (22 September 26)/AD5941_25/src/hardware/gain_control.h

#ifndef STEISTAT_GAIN_CONTROL_H
#define STEISTAT_GAIN_CONTROL_H

#include <Arduino.h>

void Hardware_FindOptimum_Rf_PGA(uint32_t CGmax, uint32_t CGmin, float freq, uint8_t* TIA_Rf, uint8_t* PGA_gain, float* closest_CG);

#endif
