mabooo18/SteiStat/(commit log)

2026-09-22 Add firmware updates 3/5/6/7, hardware KiCad export, and journal papers 0-3
    Brings in the subsequent firmware iterations (calibration-defect fix,
    signal-path/ADC-convention fix, OOP refactor), the STEI_Bstat_v1.2 KiCad
    production export, and drafts/final manuscripts for papers 0-3 covering
    the metrology, architecture, and signal-chain-defect findings on this
    instrument. Also excludes redundant duplicate zip archives and a vendor
    example subtree whose path exceeds Windows' MAX_PATH from version control.
    [E1_replicate_00.csv, E1_replicate_01.csv, E1_replicate_02.csv, E1_replicate_03.csv, E1_replicate_04.csv, E1_replicate_05.csv, E1_replicate_06.csv, E1_replicate_07.csv]
2026-09-22 Rename project from HunStat2 to SteiStat across code and docs
    Renames the instrument/firmware/tooling identifier throughout the
    codebase: per-snapshot sketch folders and source files (hunstat_gui.py,
    hunstat_data_storage.h, hunstat_status_utils.h, hunstat2_test_ui.py,
    HunStat2.ino -> steistat/SteiStat equivalents) across every Software/
    update snapshot, the lab/ analysis toolkit and its data-file headers,
    top-level READMEs, and laporan/ documentation. Journal papers under
    journal/ are intentionally left untouched (out of scope for this rename).
    [E1_replicate_00.csv, E1_replicate_01.csv, E1_replicate_02.csv, E1_replicate_03.csv, E1_replicate_04.csv, E1_replicate_05.csv, E1_replicate_06.csv, E1_replicate_07.csv]
2026-09-22 Add update 8 firmware (11-defect fix + full OOP refactor) and paper4 (HardwareX format)
    Firmware (Software/update 8): fixes RCAL mis-declaration (10k->200 ohm),
    runtime Rcal no-op, stale RTIA calibration, ADC PGA gain enum, inverted
    bias sign, VZERO2PIN sink, AFE sleep-state, and two unbounded wait loops,
    on top of the earlier loop-routing and ADC zero-point fixes. Adds
    C_ElectrochemicalMethod as a shared polymorphic base for all six
    measurement classes (CA/SWV/DPV via C_DCPotentiostatMethod, EIS, OCP, and
    a new C_CV wrapper around the legacy cv.cpp/rampTest.cpp engine), and
    fully encapsulates C_DataStorage (private fields + Get/Set accessors).
    Verified via clean compile and hardware re-test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
    [STEI_Bstat_v1.2.kicad_pcb, STEI_Bstat_v1.2.kicad_sch, bom-1.csv, ca_10k.csv, ca_baseline.csv, ca_paper_-100.csv, ca_paper_-50.csv, ca_paper_100.csv]
2026-09-22 paper4: restructure toward a standalone, forward-framed HardwareX submission
    - Retitle to foreground OOP firmware and hardware-validated accuracy;
    rewrite Highlights (methodology/openness, 4-method validity, latency+
    accuracy) and Abstract to match.
    - Remove "eleven-defect"/"nine further defects" counting language and all
    comparison/compared/compare phrasing throughout (Abstract, Hardware in
    context, Hardware description, Validation, Discussion, Conclusion),
    reframed as verification/checking against vendor reference code and as
    forward design description rather than before/after narrative. Full
    technical detail (Defect 1/2, D-RCAL..D-WAIT2, RCAL sweep table) is
    unchanged.
    - F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
2026-09-22 Merge OneDrive_1_15-09-2026 KiCad export into Hardware/
    OneDrive_1_15-09-2026 was the current, correct KiCad source (schematic,
    PCB, and the up-to-date Production/bom-1.csv already cited in paper4's
    Bill of Materials) but lived under a stray OneDrive-export name. Renamed
    it to Hardware/, which previously held only a smaller set of exported
    deliverables (Gerbers, an outdated BOM predating the RCAL1/RCAL2/RCAL3
    bank, an older CPL export, a rendered schematic PDF). The still-current
    deliverables (Gerber_PCB.zip, schematic PDF) moved into the merged
    Hardware/; the two outdated exports moved to Hardware/legacy/ with
    names/README notes making clear they're superseded by Production/bom-1.csv
    and Pr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
    [HunSta2_BOM_corr_OUTDATED.xlsx, STEI_Bstat_v1.2.kicad_pcb, STEI_Bstat_v1.2.kicad_sch, bom-1.csv, positions.csv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]
